jiu-0317/e_ink_display/3d_models/base.stl

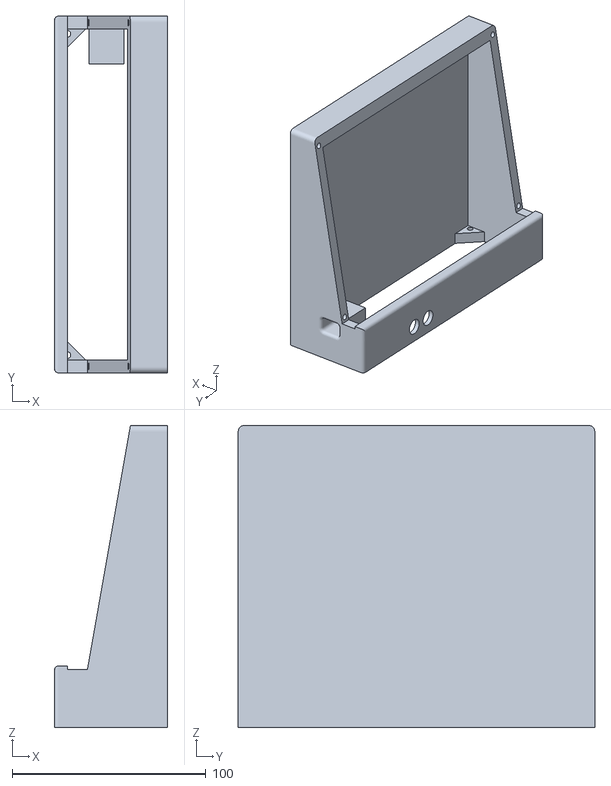
[picture p4: CAD file, 2026-10-11]
3d_models/base.stl
58.3 x 184.0 x 155.8
