jiu-0317/e_ink_display/3d_models/display_holder.stl

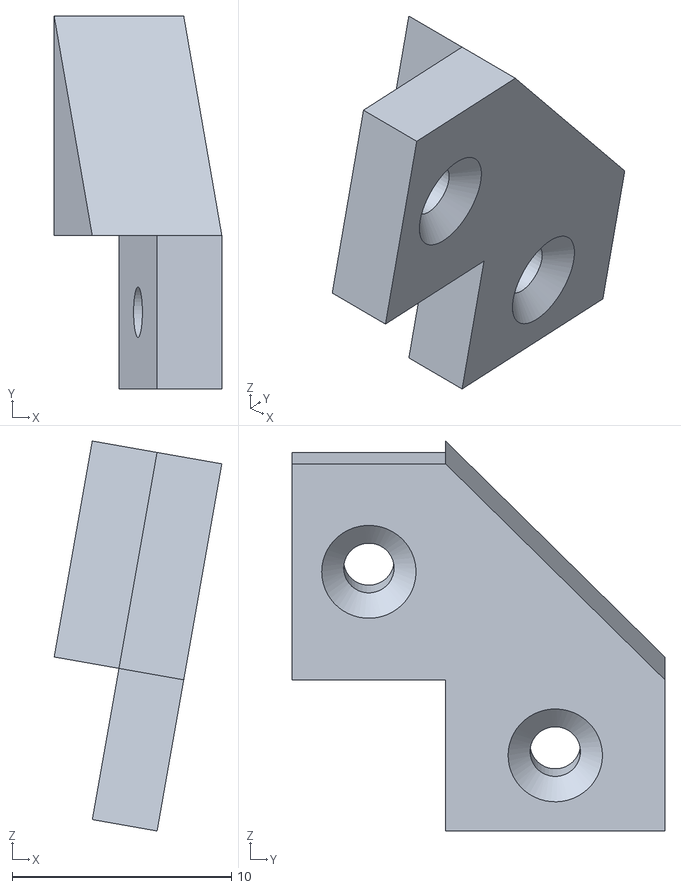
[picture p5: CAD file, 2026-10-11]
3d_models/display_holder.stl
7.65 x 17.0 x 17.8
