jiu-0317/e_ink_display/3d_models/frame.stl

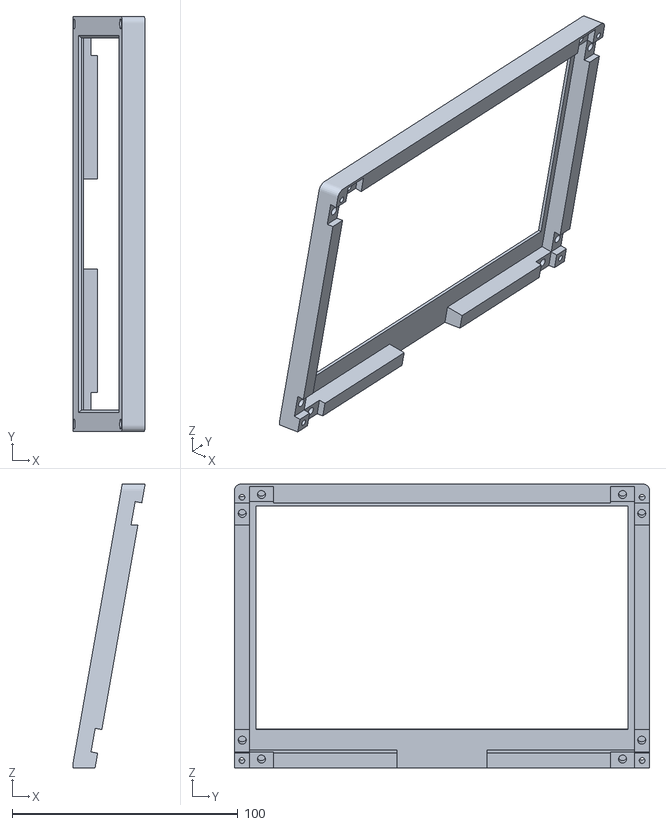
[picture p6: CAD file, 2026-10-11]
3d_models/frame.stl
32.0 x 184.0 x 125.8
