jiu-0317/e_ink_display/3d_models/botton.stl

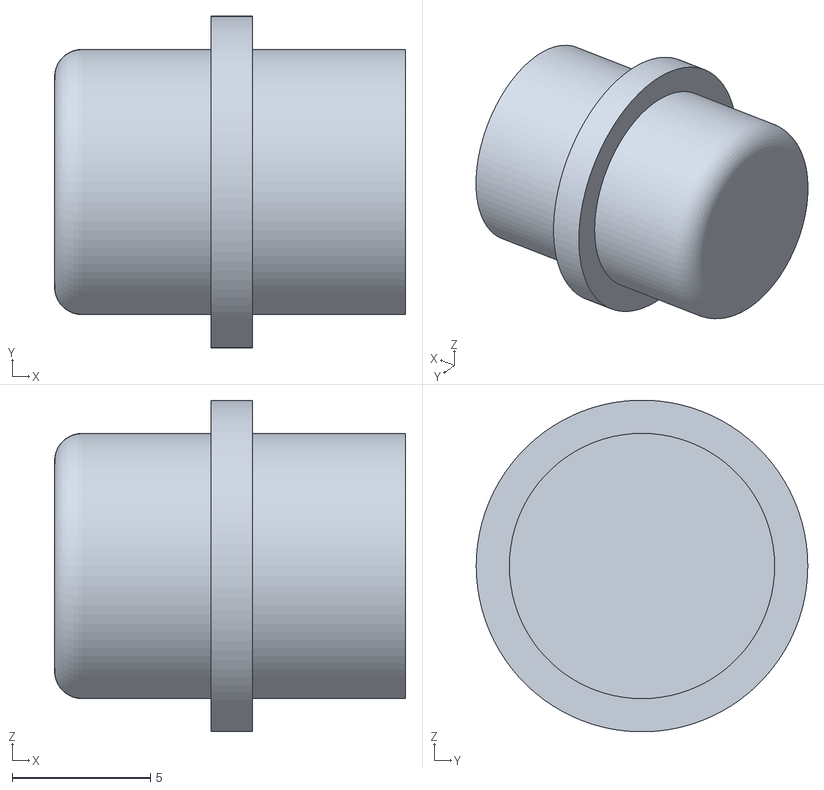
[picture p7: CAD file, 2026-10-11]
3d_models/botton.stl
12.7 x 12.0 x 12.0
