jiu-0317/e_ink_display/3d_models/bottom_plate.stl

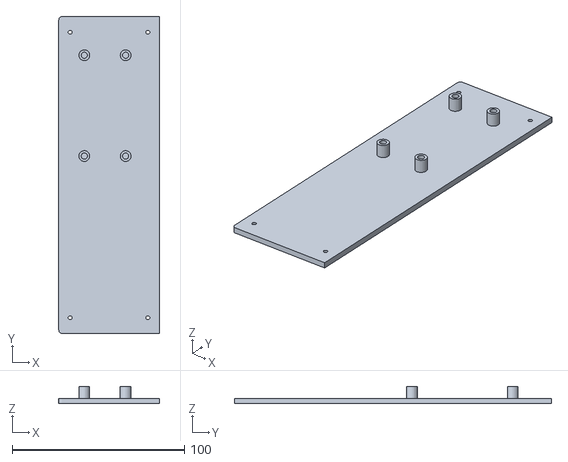
[picture p8: CAD file, 2026-10-11]
3d_models/bottom_plate.stl
58.3 x 184.0 x 9.93
