jiu-0317/e_ink_display/preview_out/phase1_test/01_full.png

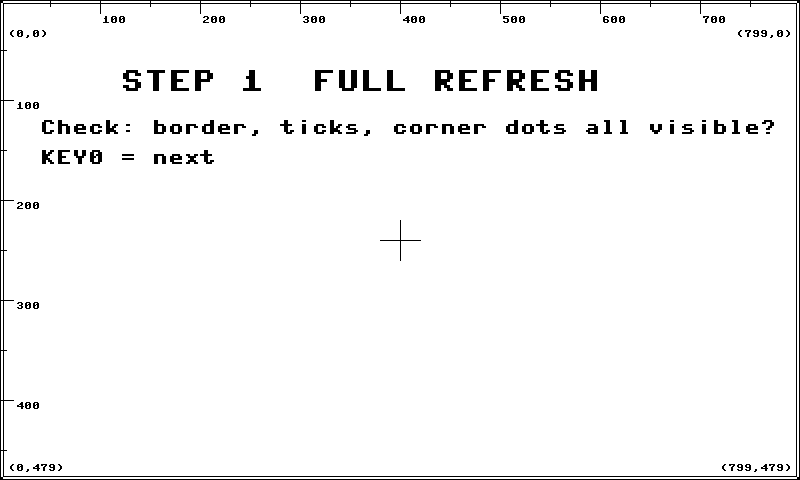
preview_out/phase1_test/01_full.png
