jiu-0317/e_ink_display/preview_out/phase1_test/03_full.png

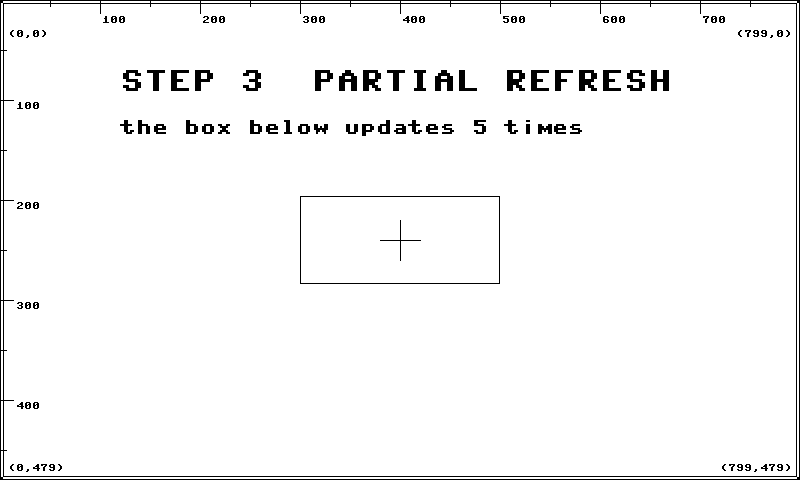
preview_out/phase1_test/03_full.png
