jiu-0317/e_ink_display/preview_out/phase1_xfer_test/01_fast.png

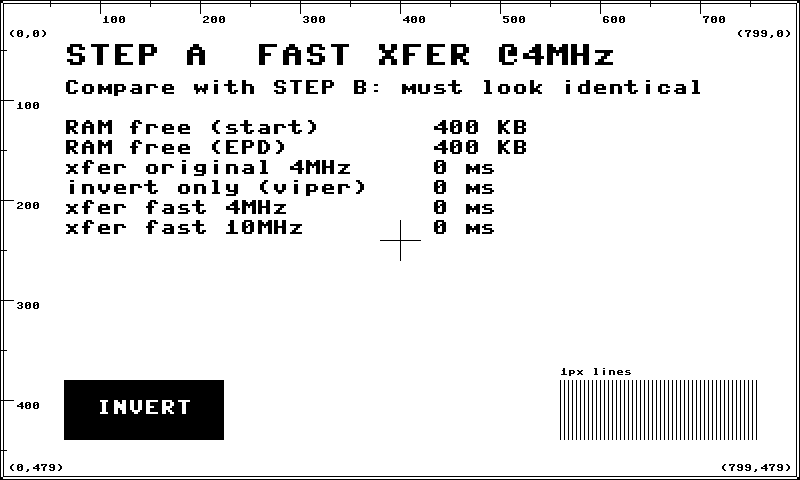
preview_out/phase1_xfer_test/01_fast.png
