jiu-0317/e_ink_display/preview_out/phase1_xfer_test/all.png

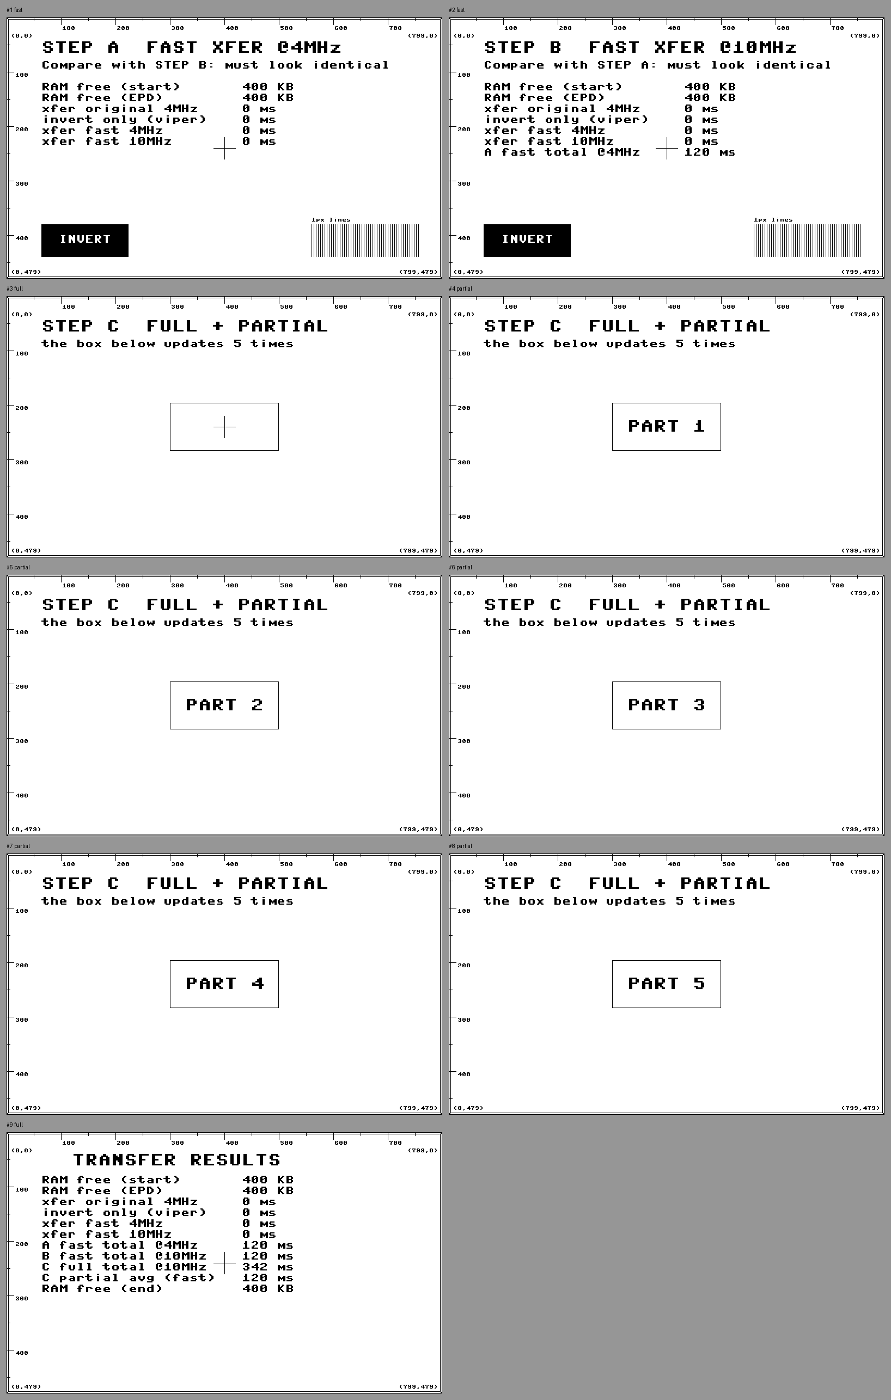
preview_out/phase1_xfer_test/all.png
