jiu-0317/e_ink_display/tools/pc_sim/font8x8.py

# MicroPython framebuf.text() 가 쓰는 8x8 글꼴 (extmod/font_petme128_8x8.h, MIT License)
# 글자당 8바이트, 각 바이트 = 세로 한 열 (LSB가 위). 문자 32~127.
FONT = bytes([
    0x00, 0x00, 0x00, 0x00, 0x00, 0x00, 0x00, 0x00,  # 32
    0x00, 0x00, 0x00, 0x4f, 0x4f, 0x00, 0x00, 0x00,  # 33
    0x00, 0x07, 0x07, 0x00, 0x00, 0x07, 0x07, 0x00,  # 34
    0x14, 0x7f, 0x7f, 0x14, 0x14, 0x7f, 0x7f, 0x14,  # 35
    0x00, 0x24, 0x2e, 0x6b, 0x6b, 0x3a, 0x12, 0x00,  # 36
    0x00, 0x63, 0x33, 0x18, 0x0c, 0x66, 0x63, 0x00,  # 37
    0x00, 0x32, 0x7f, 0x4d, 0x4d, 0x77, 0x72, 0x50,  # 38
    0x00, 0x00, 0x00, 0x04, 0x06, 0x03, 0x01, 0x00,  # 39
    0x00, 0x00, 0x1c, 0x3e, 0x63, 0x41, 0x00, 0x00,  # 40
    0x00, 0x00, 0x41, 0x63, 0x3e, 0x1c, 0x00, 0x00,  # 41
    0x08, 0x2a, 0x3e, 0x1c, 0x1c, 0x3e, 0x2a, 0x08,  # 42
    0x00, 0x08, 0x08, 0x3e, 0x3e, 0x08, 0x08, 0x00,  # 43
    0x00, 0x00, 0x80, 0xe0, 0x60, 0x00, 0x00, 0x00,  # 44
    0x00, 0x08, 0x08, 0x08, 0x08, 0x08, 0x08, 0x00,  # 45
    0x00, 0x00, 0x00, 0x60, 0x60, 0x00, 0x00, 0x00,  # 46
    0x00, 0x40, 0x60, 0x30, 0x18, 0x0c, 0x06, 0x02,  # 47
    0x00, 0x3e, 0x7f, 0x49, 0x45, 0x7f, 0x3e, 0x00,  # 48
    0x00, 0x40, 0x44, 0x7f, 0x7f, 0x40, 0x40, 0x00,  # 49
    0x00, 0x62, 0x73, 0x51, 0x49, 0x4f, 0x46, 0x00,  # 50
    0x00, 0x22, 0x63, 0x49, 0x49, 0x7f, 0x36, 0x00,  # 51
    0x00, 0x18, 0x18, 0x14, 0x16, 0x7f, 0x7f, 0x10,  # 52
    0x00, 0x27, 0x67, 0x45, 0x45, 0x7d, 0x39, 0x00,  # 53
    0x00, 0x3e, 0x7f, 0x49, 0x49, 0x7b, 0x32, 0x00,  # 54
    0x00, 0x03, 0x03, 0x79, 0x7d, 0x07, 0x03, 0x00,  # 55
    0x00, 0x36, 0x7f, 0x49, 0x49, 0x7f, 0x36, 0x00,  # 56
    0x00, 0x26, 0x6f, 0x49, 0x49, 0x7f, 0x3e, 0x00,  # 57
    0x00, 0x00, 0x00, 0x24, 0x24, 0x00, 0x00, 0x00,  # 58
    0x00, 0x00, 0x80, 0xe4, 0x64, 0x00, 0x00, 0x00,  # 59
    0x00, 0x08, 0x1c, 0x36, 0x63, 0x41, 0x41, 0x00,  # 60
    0x00, 0x14, 0x14, 0x14, 0x14, 0x14, 0x14, 0x00,  # 61
    0x00, 0x41, 0x41, 0x63, 0x36, 0x1c, 0x08, 0x00,  # 62
    0x00, 0x02, 0x03, 0x51, 0x59, 0x0f, 0x06, 0x00,  # 63
    0x00, 0x3e, 0x7f, 0x41, 0x4d, 0x4f, 0x2e, 0x00,  # 64
    0x00, 0x7c, 0x7e, 0x0b, 0x0b, 0x7e, 0x7c, 0x00,  # 65
    0x00, 0x7f, 0x7f, 0x49, 0x49, 0x7f, 0x36, 0x00,  # 66
    0x00, 0x3e, 0x7f, 0x41, 0x41, 0x63, 0x22, 0x00,  # 67
    0x00, 0x7f, 0x7f, 0x41, 0x63, 0x3e, 0x1c, 0x00,  # 68
    0x00, 0x7f, 0x7f, 0x49, 0x49, 0x41, 0x41, 0x00,  # 69
    0x00, 0x7f, 0x7f, 0x09, 0x09, 0x01, 0x01, 0x00,  # 70
    0x00, 0x3e, 0x7f, 0x41, 0x49, 0x7b, 0x3a, 0x00,  # 71
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
])
